FunTimesWithTheTA/SuperSimpleEXGCircuit/README.md

# SuperSimpleEXGCircuit
Super simple circuit for measuring potential signals such as ECG, EEG, EOG, etc.
