FunTimesWithTheTA/SuperSimpleEXGCircuit/Multimedia/SimpleEXGCircuit-sch.png

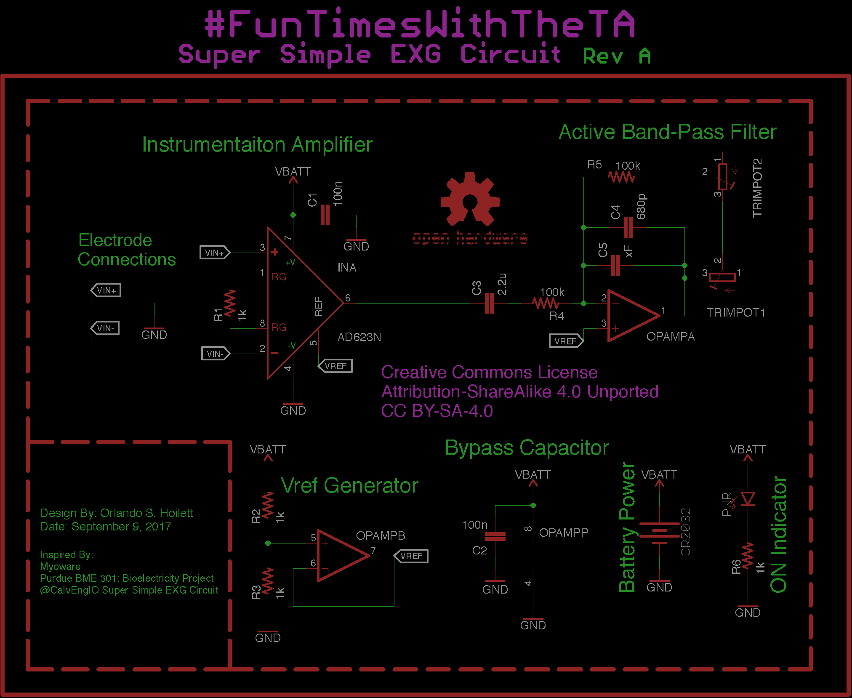
Multimedia/SimpleEXGCircuit-sch.png
