FunTimesWithTheTA/SuperSimpleEXGCircuit/Docs/EXGCircuit-FunTimes-BOM-Extended.xlsx

@CalvEngIO LiPo Battery Breadboard Supply with Charging Rev E |  |  |  |  |  |  |  |  |  |  | Total | #REF! | Price Break | #REF! | $9.44 | $9.35 | $9.04 | #REF! |  | Cost w/ Price Break | $18.85 | #VALUE! | $36.17 | $15.49 | $15.47 |  | Bulk Cost | $451.64 | $1659.79 | #VALUE! | $7811.98 | $14715.23
BOM # | Comment | Designator | Description | Mounting Type | Package | Manufacturer | Manufacturer Part Number | Supplier | Supplier Part Number | Price per unit | Quantity | Price Total |  | 25 | 100 | 250 | 500 | 1000 |  |  | 25 | 100 | 250 | 500 | 1000 |  |  | 25 | 100 | 250 | 500 | 1000
1 | AD623 | INA | IC OPAMP INSTR 800KHZ RRO 8DIP | THT | 8DIP | Analog Devices | AD623ANZ | Digi-Key | AD623ANZ-ND | $6.31 | 1 | $6.31 |  | $5.36 | $4.64 | $4.64 | $3.95 | $3.33 |  |  | $5.36 | $4.64 | $4.64 | $3.95 | $3.33 |  |  | $133.88 | $464.10 | $1160.25 | $1975.40 | $3332.00
2 | MCP6002 |  | General Purpose Amplifier 2 Circuit Rail-to-Rail 8-MSOP | THT | 8DIP | Microchip Technology | MCP6002-I/P | Digi-Key | MCP6002-I/P-ND | $0.35 | 1 | $0.35 |  | $0.29 | $0.26 | $0.26 | $0.26 | $0.26 |  |  | $0.25 | #VALUE! | $6.25 |  | $0.25 | #VALUE! | $250.00 |  | $0.25 | #VALUE! | $25.00
3 | 1k resistor | R1,R2,R3,R6 |  | THT |  |  |  | Digi-Key |  |  | 1 | $0.00 |  | $0.32 | $0.20 | $0.20 | $0.13 | $0.10 |  |  | $0.32 | $0.20 | $0.20 | $0.13 | $0.10 |  |  | $7.92 | $19.73 | $49.33 | $67.48 | $103.82
4 | 100k resistor | R4,R5 |  | THT |  |  |  | Digi-Key |  |  | 1 | $0.00 |  | $0.37 | $0.31 | $0.27 | $0.26 | $0.26 |  |  | $0.37 | $0.31 | $0.27 | $0.26 | $0.26 |  |  | $9.36 | $30.56 | $68.61 | $130.98 | $261.96
5 | 100nF capacitor | C1,C2 |  | THT
6 | 2.2uF capacitor | C3 |  | THT |  |  |  | Digi-Key |  |  | 2 | $0.00 |  | $0.24 | $0.18 | $0.13 | $0.10 | $0.08 |  |  | $0.48 | $0.37 | $0.26 | $0.21 | $0.16 |  |  | $12.12 | $36.68 | $64.90 | $103.82 | $159.20
7 | 680pF capacitor | C4 |  | THT |  |  |  | Digi-Key |  |  | 1 | $0.00 |  | $0.25 | $0.20 | $0.20 | $0.16 | $0.14 |  |  | $0.25 | $0.20 | $0.20 | $0.16 | $0.14 |  |  | $6.17 | $20.32 | $50.79 | $80.30 | $137.87
8 | Potentiometer |  | 1M Ohm 1 Gang Linear Panel Mount Potentiometer None 1 Turn Conductive Plastic 0.2W, 1/5W PC Pins | THT | Panel Mount | TT Electronics/BI | P160KN-0EC15B1MEG | Digi-Key | 987-1711-ND | $0.76 |  | #REF! | $0.62 | #REF! | $0.00 |  | $0.56 | #REF! | $280.50 |  | $0.54 | #REF! | $13.48 |  | $0.51 | #REF! | $506.00 |  | $0.42 | #REF! | $41.80
9 | LED | PWR |  | THT |  |  |  | Digi-Key |  |  | 1 | $0.00 |  | $0.05 | $0.04 | $0.03 | $0.03 | $0.03 |  |  | $0.05 | $0.04 | $0.03 | $0.03 | $0.03 |  |  | $1.37 | $3.85 | $8.14 | $15.05 | $26.60
10 | CR2032 | CR2032 | 20MM COIN BATT BREAKOUT W/SWITCH |  |  | Adafruit Industries LLC | 1871 | Digi-Key | 1528-1458-ND | $3.30 | 3 | $9.90 |  | $3.50 | $3.50 | $3.50 | $3.50 | $3.50 |  |  | $10.50 | $10.50 | $10.50 | $10.50 | $10.50 |  |  | $262.50 | $1050.00 | $2625.00 | $5250.00 | $10500.00
11 | ECG Electrodes | VIN+,VIN-,GND |  | NA |  |  |  | Digi-Key |  |  | 5 | $0.00 |  | $0.09 | $0.04 | $0.04 | $0.03 | $0.03 |  |  | $0.47 | $0.22 | $0.22 | $0.15 | $0.13 |  |  | $11.75 | $22.00 | $55.00 | $77.15 | $127.75
11 |  |  |  | SMD |  |  |  | Digi-Key |  |  | 2 | $0.00 |  | $0.10 | $0.05 | $0.05 | $0.03 | $0.03 |  |  | $0.19 | $0.09 | $0.09 | $0.06 | $0.05 |  |  | $4.85 | $9.12 | $22.80 | $32.00 | $53.00
12 |  |  |  | SMD |  |  |  | Digi-Key |  |  | 1 | $0.00 |  | $0.01 | $0.01 | $0.01 | $0.004 | $0.00315 |  |  | $0.01 | $0.01 | $0.01 | $0.004 | $0.00315 |  |  | $0.33 | $0.56 | $1.40 | $2.00 | $3.15
13 |  |  |  | SMD |  |  |  | Digi-Key |  |  | 3 | $0.00 |  | $0.01 | $0.01 | $0.01 | $0.01 | $0.00247 |  |  | $0.04 | $0.02 | $0.02 | $0.02 | $0.01 |  |  | $1.05 | $1.65 | $4.12 | $8.25 | $7.41
 | Arduino |  |  | SMD |  |  |  | Digi-Key |  |  | 1 | $0.00 |  | $0.01 | $0.01 | $0.01 | $0.01 | $0.00247 |  |  | $0.01 | $0.01 | $0.01 | $0.01 | $0.00247 |  |  | $0.35 | $0.55 | $1.38 | $2.75 | $2.47
 | USB Cable
 | ECG Electrodes
