FunTimesWithTheTA/SuperSimpleEXGCircuit/Multimedia/SimpleEXGCircuit-white-sch.pdf

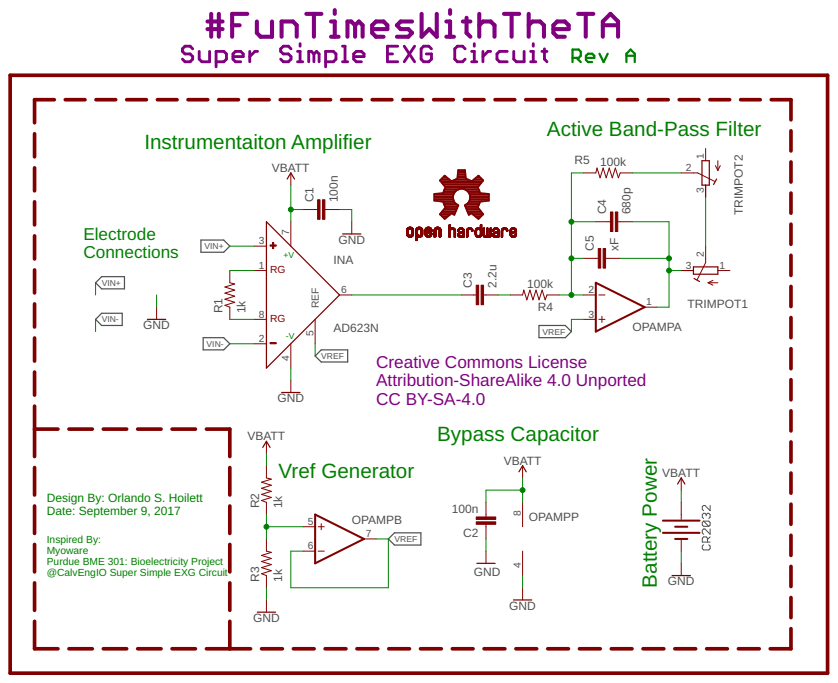
[picture p20: page 1]

Active Band-Pass Filter

Design By: Orlando S. Hoilett
Date: September 9, 2017

Inspired By: Myoware Purdue BME 301: Bioelectricity Project @CalvEngIO Super Simple EXG Circuit
