FunTimesWithTheTA/SuperSimpleEXGCircuit/Hardware/SimpleEXGCircuit.brd

## EAGLE design Hardware/SimpleEXGCircuit.brd (2018-06-21)

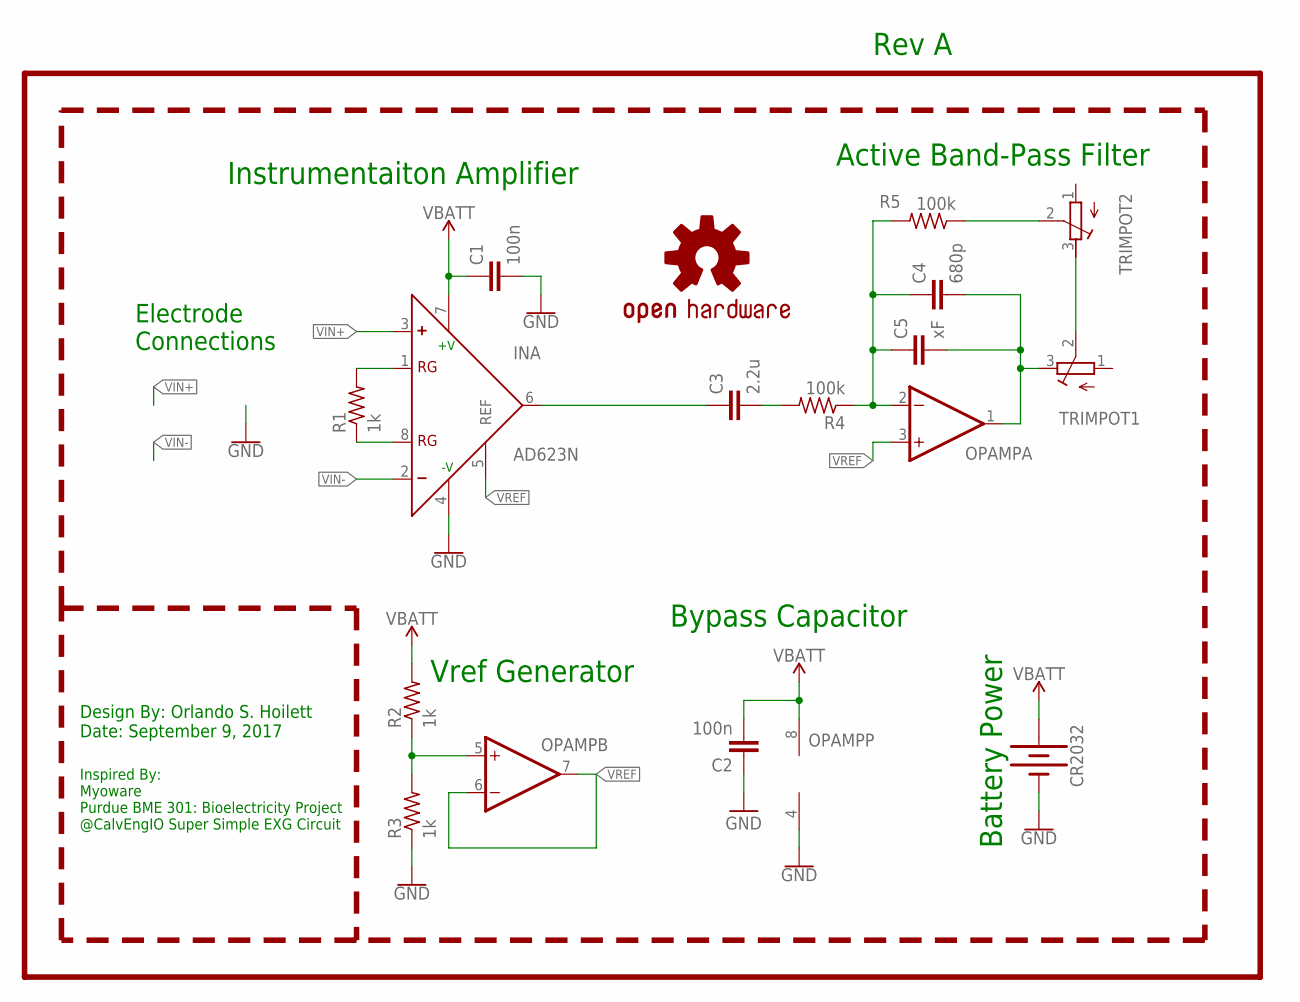
[picture p21: schematic SimpleEXGCircuit.sch]

Parts:
C1, C2: 100n; C050-030X075
C3: 2.2u; C050-030X075
C4: 680p; C050-030X075
C5: xF; C050-030X075
CR2032: BATTERY-20MM_SMD_4LEGS_OVERPASTE; BATTCON_20MM_4LEGS_OVERPASTE
INA: AD623N; DIL08
LOGO1: OSHW-LOGOS; OSHW-LOGO-S
OPAMP: OP-DUALDIP08; DIL08
R1, R2, R3: 1k; 0207/10
R4, R5: 100k; 0207/10
TRIMPOT1, TRIMPOT2: TRIM-POT-P160; 16MMROTARYPOT

Connections:
GND: C1.2, C2.1, CR2032.2 (-), INA.4 (-V), OPAMP.4 (V-), R3.1
unnamed: R5.1, TRIMPOT2.2 (S)
unnamed: TRIMPOT1.2 (S), TRIMPOT2.3 (E)
unnamed: OPAMP.5 (+IN), R2.1, R3.2
unnamed: C3.2, R4.2
unnamed: C4.1, C5.1, OPAMP.2 (-IN), R4.1, R5.2
unnamed: C3.1, INA.6 (OUT)
unnamed: INA.1 (RG), R1.2
unnamed: INA.8 (RG), R1.1
OUT: C4.2, C5.2, OPAMP.1 (OUT), TRIMPOT1.3 (E)
VIN+: INA.3 (+)
VIN-: INA.2 (-)
VREF: INA.5 (REF), OPAMP.3 (+IN), OPAMP.6 (-IN), OPAMP.7 (OUT)
V_BATT: C1.1, C2.2, CR2032.1 (+), INA.7 (+V), OPAMP.8 (V+), R2.2

Notes on the sheet:
Instrumentaiton Amplifier
Active Band-Pass Filter
Vref Generator
Battery Power
Bypass Capacitor
Rev A
Electrode Connections
Design By: Orlando S. Hoilett Date: September 9, 2017
Inspired By: Myoware Purdue BME 301: Bioelectricity Project @CalvEngIO Super Simple EXG Circuit

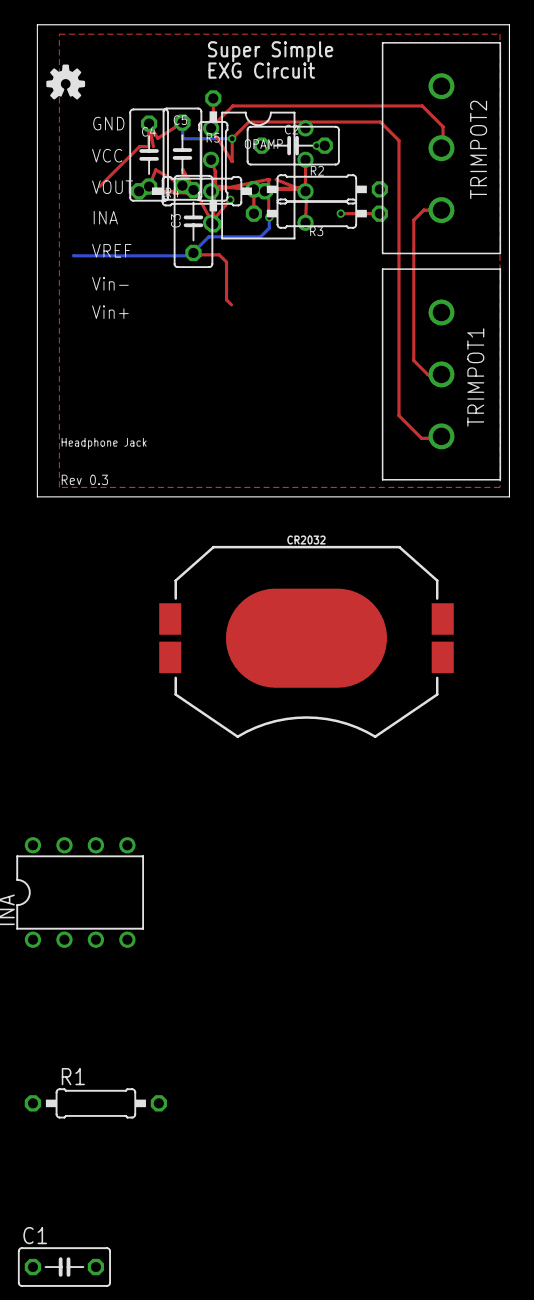
[picture p22: board SimpleEXGCircuit.brd from above]

Board: 2 copper layers, 38.1 x 38.1 mm, 16 parts (0 on the bottom side), 12 nets.
