FunTimesWithTheTA/SuperSimpleEXGCircuit/(notices)

Notices in the files:
Hardware/SimpleEXGCircuit.sch:
Creative Commons License
CC BY-SA-4.0
parts and their libraries:
SparkFun-Aesthetics: Licensing: Creative Commons ShareAlike 4.0 International - https://creativecommons.org/licenses/by-sa/4.0
